beRto-/automatic_vacuum_switch/(commit log)

2020-04-07 initial commit - moving project into a git repository
    [ACS712 current sensor calculations.xlsx]
2020-04-08 change from system schematic to connection details
